RobFro96/MSP430-NRF24-WSN/3d_design/sensor_housing_nomag_220306.stl

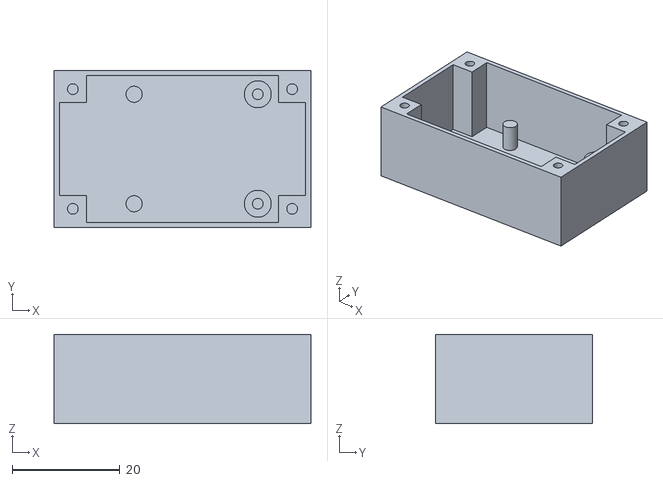
[picture p4: CAD file, 2022-03-27]
3d_design/sensor_housing_nomag_220306.stl
47.7 x 29.2 x 16.6
