RobFro96/MSP430-NRF24-WSN/3d_design/sensor_housing_220306.stl

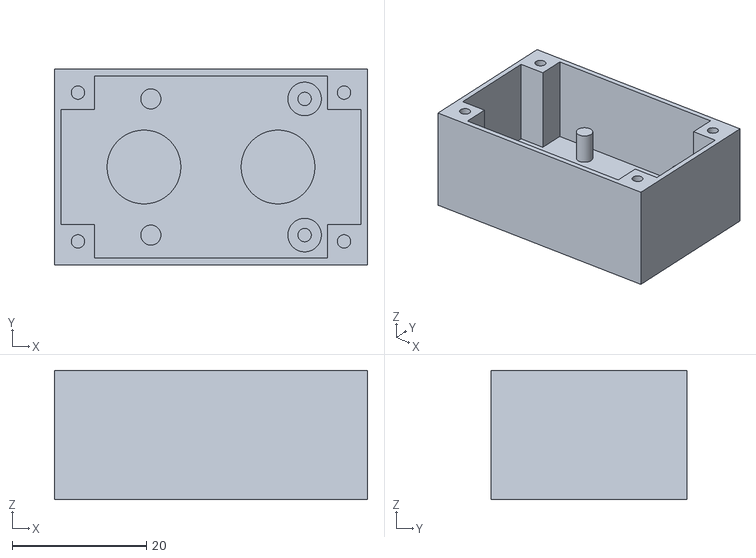
[picture p5: CAD file, 2022-03-06]
3d_design/sensor_housing_220306.stl
46.7 x 29.2 x 19.3
