RobFro96/MSP430-NRF24-WSN/3d_design/weather_station_holder_220220.stl

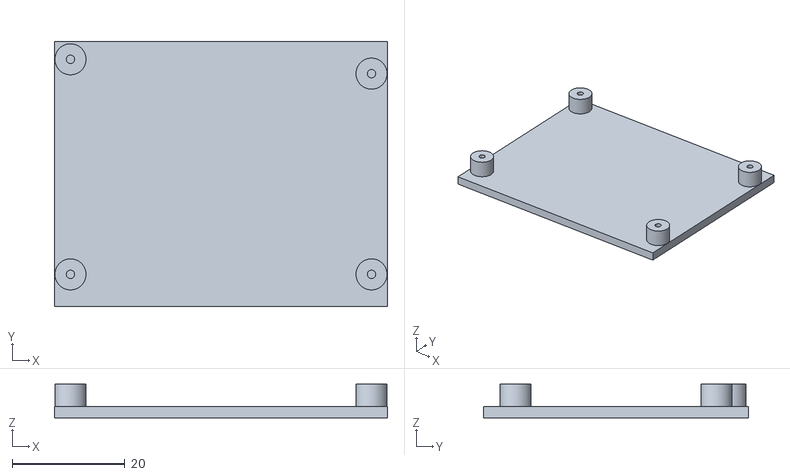
[picture p7: CAD file, 2022-02-20]
3d_design/weather_station_holder_220220.stl
59.0 x 47.0 x 6.00
