RobFro96/MSP430-NRF24-WSN/3d_design/central_housing_220218.stl

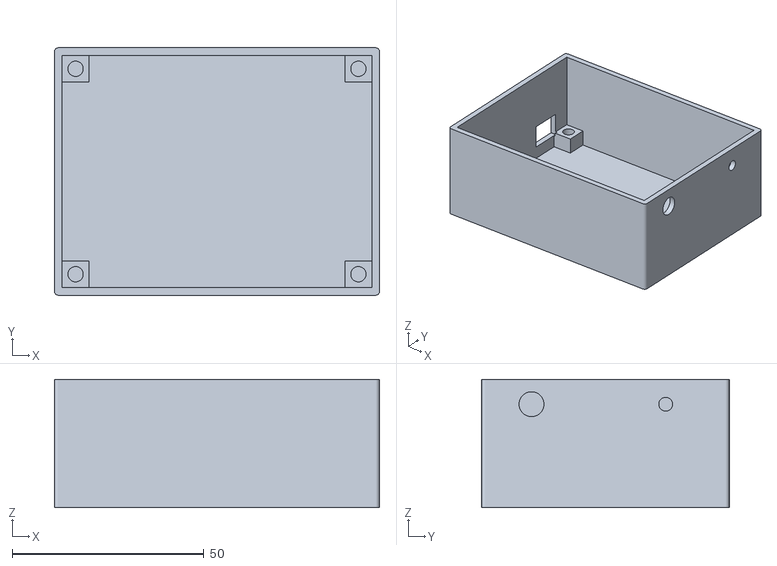
[picture p8: CAD file, 2022-02-19]
3d_design/central_housing_220218.stl
84.8 x 64.6 x 33.5
