RobFro96/MSP430-NRF24-WSN/(list of files, cad)

Other CAD files:
3d_design/sensor_housing_nomag.scad
3d_design/central_housing_220218.scad
3d_design/central_housing_lid_220218.scad
