RobFro96/MSP430-NRF24-WSN/eagle/sensor-water/sensor-water.brd

## EAGLE design eagle/sensor-water/sensor-water.brd (2025-02-25)

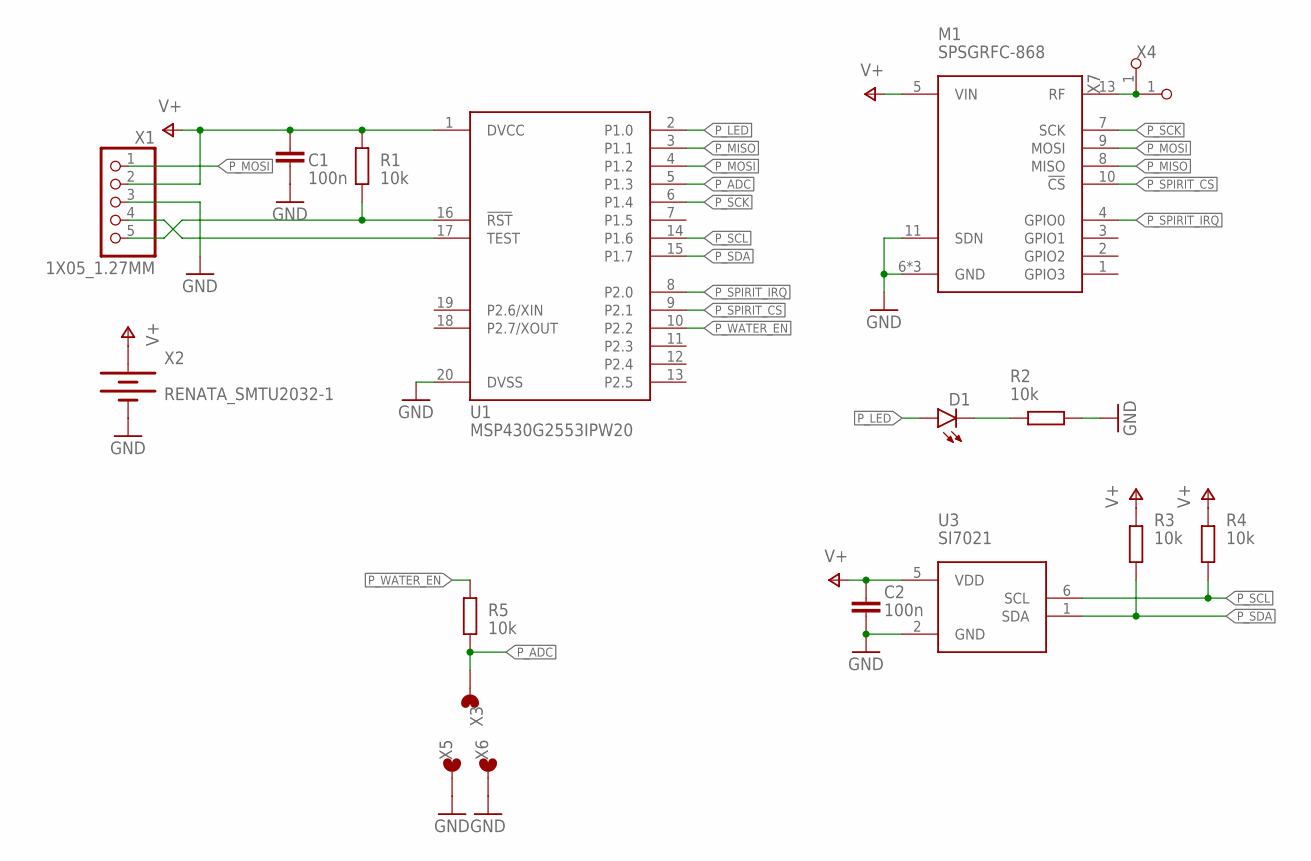
[picture p10: schematic sensor-water.sch]

Parts:
C1, C2: 100n; C0805_HAND
D1: LEDCHIPLED_0805; CHIPLED_0805
M1: SPSGRFC-868
R1, R2, R3, R4, R5: 10k; R0805_HAND
U1: MSP430G2553IPW20; PW20
U3: SI7021; DFN6-3X3
X1: 1X05_1.27MM
X2: RENATA_SMTU2032-1
X3, X5, X6: WASSERW_FOOTS
X4, X7: PINHD_1_RND; 1X01_NOSILK

Connections:
GND: C1.2, C2.2, M1.6 (GND), M1.11 (SDN), M1.12 (GND), M1.14 (GND), R2.2, U1.20 (DVSS), U3.2 (GND), X1.3, X2.2 (-), X5.1, X6.1
unnamed: D1.C, R2.1
unnamed: R1.1, U1.16 (!RST!), X1.5
unnamed: U1.17 (TEST), X1.4
unnamed: M1.13 (RF), X4.1, X7.1
P_ADC: R5.1, U1.5 (P1.3), X3.1
P_LED: D1.A, U1.2 (P1.0)
P_MISO: M1.8 (MISO), U1.3 (P1.1)
P_MOSI: M1.9 (MOSI), U1.4 (P1.2), X1.1
P_SCK: M1.7 (SCK), U1.6 (P1.4)
P_SCL: R4.1, U1.14 (P1.6), U3.6 (SCL)
P_SDA: R3.1, U1.15 (P1.7), U3.1 (SDA)
P_SPIRIT_!CS: M1.10 (!CS), U1.9 (P2.1)
P_SPIRIT_IRQ: M1.4 (GPIO0), U1.8 (P2.0)
P_WATER_EN: R5.2, U1.10 (P2.2)
V+: C1.1, C2.1, M1.5 (VIN), R1.2, R3.2, R4.2, U1.1 (DVCC), U3.5 (VDD), X1.2, X2.1 (+)

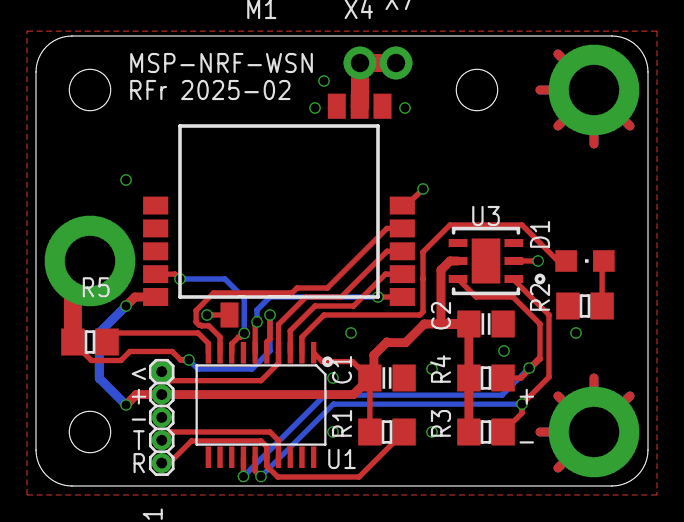
[picture p11: board sensor-water.brd from above]

Board: 2 copper layers, 34.0 x 25.0 mm, 18 parts (1 on the bottom side), 16 nets.
