RobFro96/MSP430-NRF24-WSN/eagle/sensor-multichannel/sensor-multichannel.brd

## EAGLE design eagle/sensor-multichannel/sensor-multichannel.brd (2025-02-25)

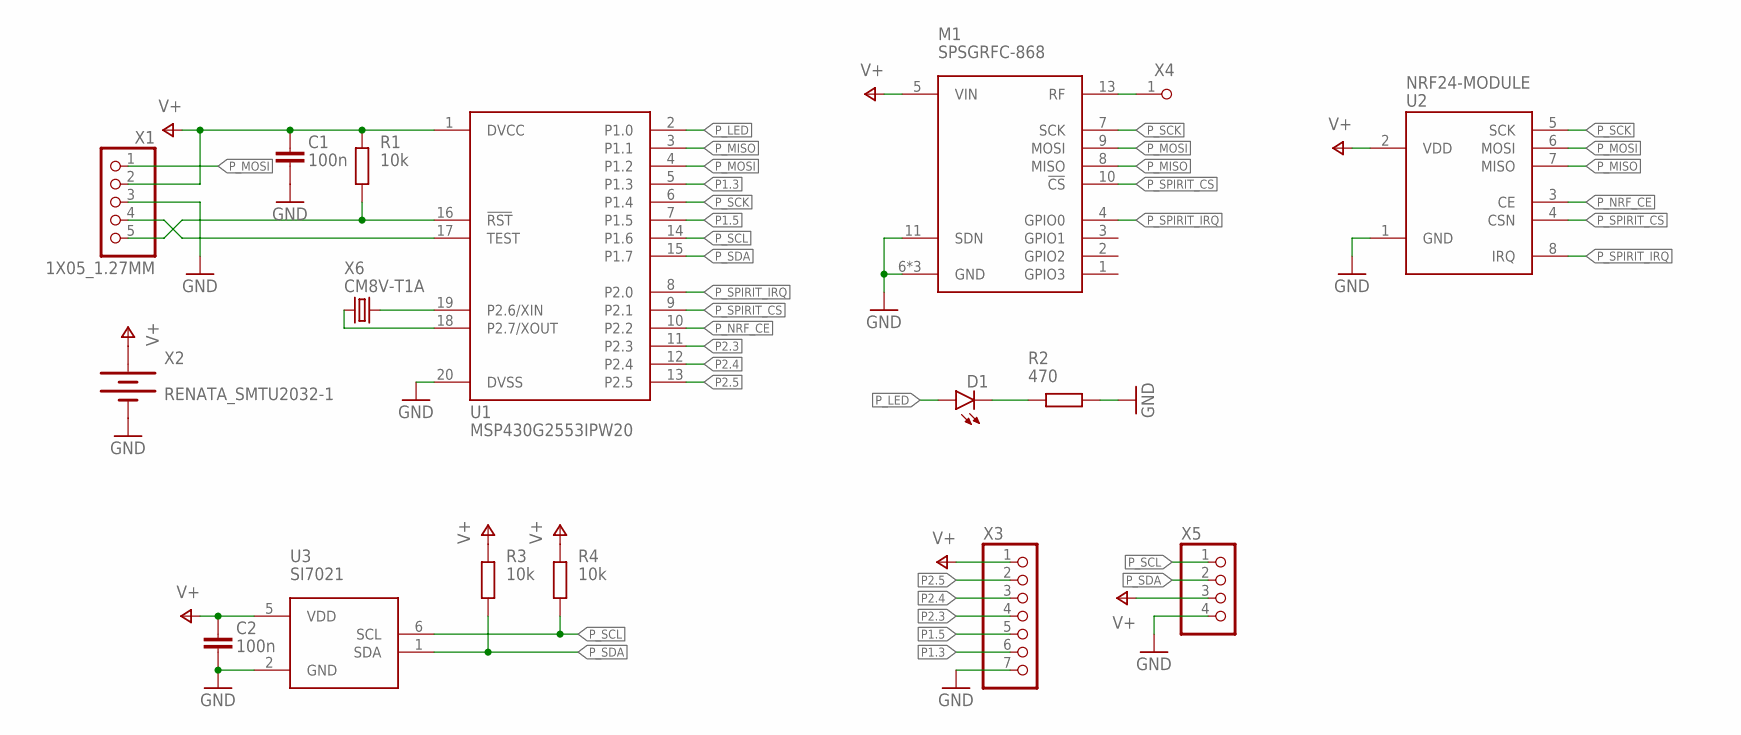
[picture p12: schematic sensor-multichannel.sch]

Parts:
C1, C2: 100n; C0603
D1: LEDCHIPLED_0805; CHIPLED_0805
M1: SPSGRFC-868
R1, R3, R4: 10k; R0603
R2: 470; R0603
U1: MSP430G2553IPW20; PW20
U2: NRF24-MODULE
U3: SI7021; DFN6-3X3
X1: 1X05_1.27MM
X2: RENATA_SMTU2032-1
X3: PINHD_7_RNDNS; 1X07_NOSILK
X4: PINHD_1_RND; 1X01_NOSILK
X5: PINHD_4_RNDNS; 1X04_NOSILK
X6: CM8V-T1A

Connections:
GND: C1.2, C2.2, M1.6 (GND), M1.11 (SDN), M1.12 (GND), M1.14 (GND), R2.2, U1.20 (DVSS), U2.1 (GND), U3.2 (GND), X1.3, X2.2 (-), X3.7, X5.4
unnamed: D1.C, R2.1
unnamed: R1.1, U1.16 (!RST!), X1.5
unnamed: U1.17 (TEST), X1.4
unnamed: M1.13 (RF), X4.1
unnamed: U1.19 (P2.6/XIN), X6.P$2 (2)
unnamed: U1.18 (P2.7/XOUT), X6.P$1 (1)
P1.3: U1.5 (P1.3), X3.6
P1.5: U1.7 (P1.5), X3.5
P2.3: U1.11 (P2.3), X3.4
P2.4: U1.12 (P2.4), X3.3
P2.5: U1.13 (P2.5), X3.2
P_LED: D1.A, U1.2 (P1.0)
P_MISO: M1.8 (MISO), U1.3 (P1.1), U2.7 (MISO)
P_MOSI: M1.9 (MOSI), U1.4 (P1.2), U2.6 (MOSI), X1.1
P_NRF_CE: U1.10 (P2.2), U2.3 (CE)
P_SCK: M1.7 (SCK), U1.6 (P1.4), U2.5 (SCK)
P_SCL: R4.1, U1.14 (P1.6), U3.6 (SCL), X5.1
P_SDA: R3.1, U1.15 (P1.7), U3.1 (SDA), X5.2
P_SPIRIT_!CS: M1.10 (!CS), U1.9 (P2.1), U2.4 (CSN)
P_SPIRIT_IRQ: M1.4 (GPIO0), U1.8 (P2.0), U2.8 (IRQ)
V+: C1.1, C2.1, M1.5 (VIN), R1.2, R3.2, R4.2, U1.1 (DVCC), U2.2 (VDD), U3.5 (VDD), X1.2, X2.1 (+), X3.1, X5.3

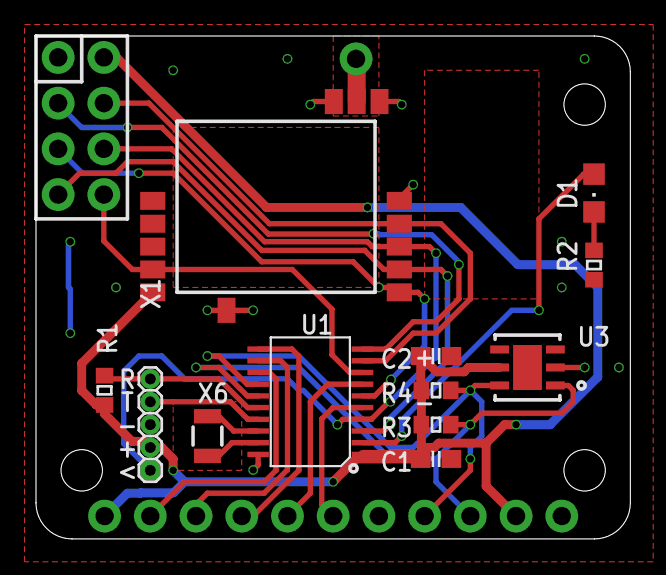
[picture p13: board sensor-multichannel.brd from above]

Board: 2 copper layers, 33.0 x 27.9 mm, 17 parts (1 on the bottom side), 22 nets.
