RobFro96/MSP430-NRF24-WSN/eagle/rpi_shield/rpi-shield.brd

## EAGLE design eagle/rpi_shield/rpi-shield.brd (2022-04-09)

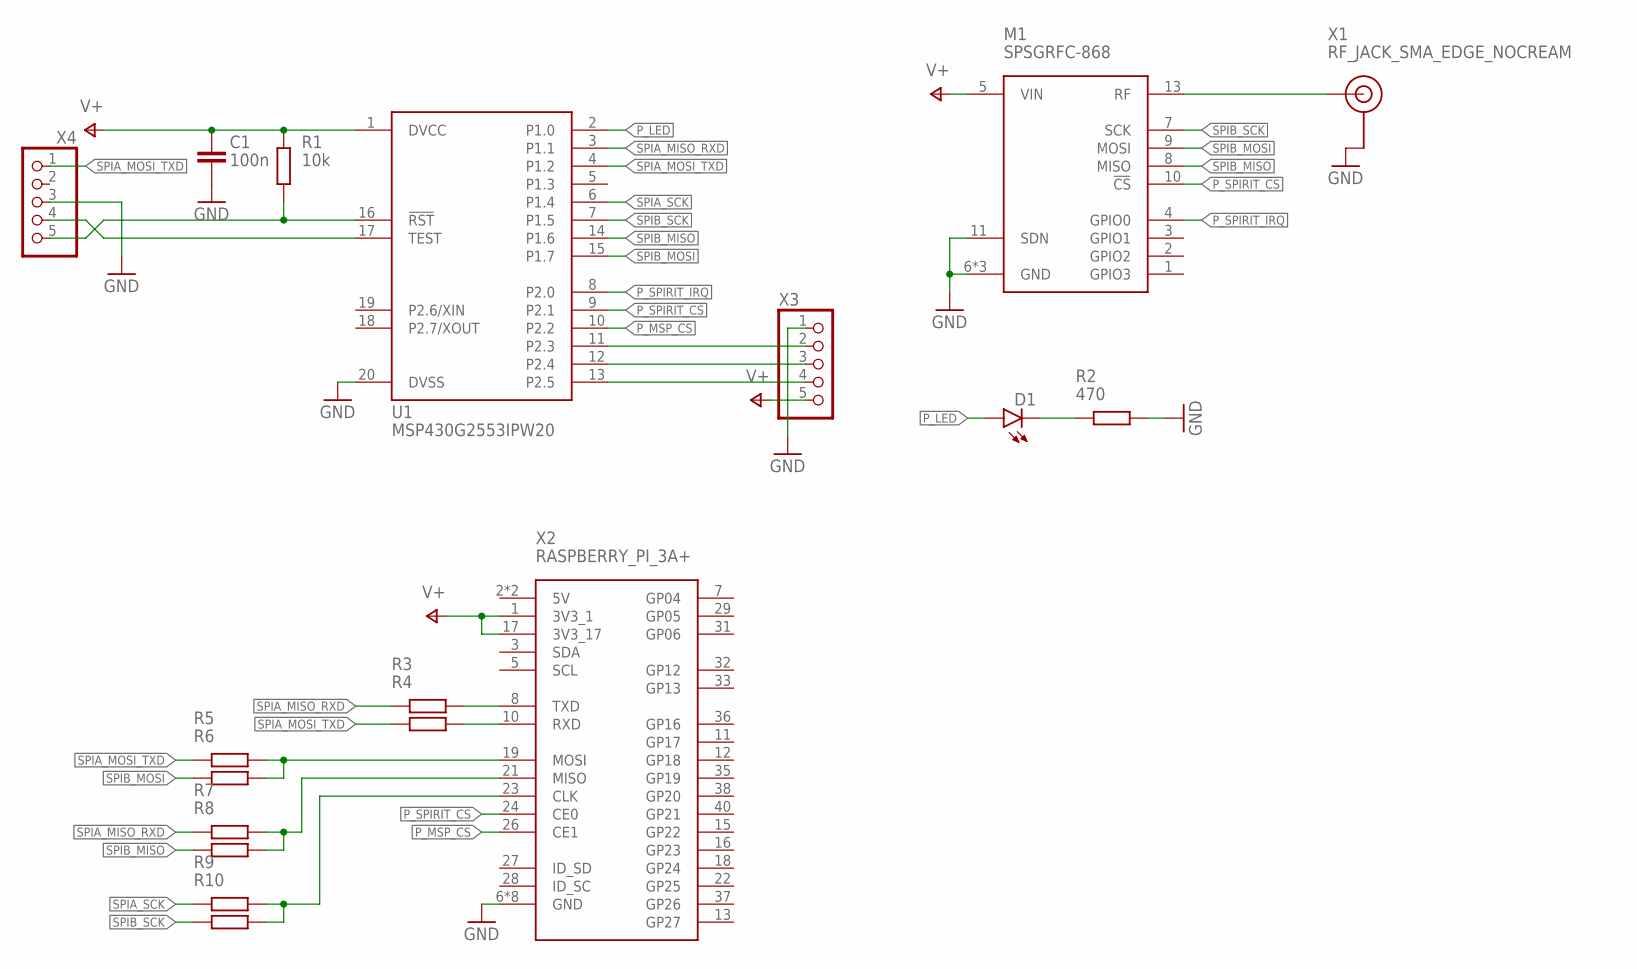
[picture p14: schematic rpi-shield.sch]

Parts:
C1: 100n; C0603
D1: LEDCHIPLED_0805; CHIPLED_0805
M1: SPSGRFC-868
R1: 10k; R0603
R2: 470; R0603
R3, R4, R5, R6, R7, R8, R9, R10: R0603_STOP
U1: MSP430G2553IPW20; PW20
X1: RF_JACK_SMA_EDGE_NOCREAM; RF_SMA_JACK_EDGE_NOCREAM
X2: RASPBERRY_PI_3A+
X3, X4: PINHD_5_RND; 1X05

Connections:
GND: C1.2, M1.6 (GND), M1.11 (SDN), M1.12 (GND), M1.14 (GND), R2.2, U1.20 (DVSS), X1.2 (GND), X1.3 (GND), X1.4 (GND), X1.5 (GND), X2.6 (GND), X2.9 (GND), X2.14 (GND), X2.20 (GND), X2.25 (GND), X2.30 (GND), X2.34 (GND), X2.39 (GND), X3.1, X4.3
unnamed: D1.C, R2.1
unnamed: R1.1, U1.16 (!RST!), X4.5
unnamed: U1.17 (TEST), X4.4
unnamed: M1.13 (RF), X1.1 (SIGNAL)
unnamed: R3.2, X2.8 (TXD)
unnamed: R4.2, X2.10 (RXD)
unnamed: R5.2, R6.2, X2.19 (MOSI)
unnamed: R7.2, R8.2, X2.21 (MISO)
unnamed: R9.2, R10.2, X2.23 (CLK)
unnamed: U1.13 (P2.5), X3.4
unnamed: U1.12 (P2.4), X3.3
unnamed: U1.11 (P2.3), X3.2
P_LED: D1.A, U1.2 (P1.0)
P_MSP_!CS: U1.10 (P2.2), X2.26 (CE1)
P_SPIRIT_!CS: M1.10 (!CS), U1.9 (P2.1), X2.24 (CE0)
P_SPIRIT_IRQ: M1.4 (GPIO0), U1.8 (P2.0)
SPIA_MISO_RXD: R3.1, R7.1, U1.3 (P1.1)
SPIA_MOSI_TXD: R4.1, R5.1, U1.4 (P1.2), X4.1
SPIA_SCK: R9.1, U1.6 (P1.4)
SPIB_MISO: M1.8 (MISO), R8.1, U1.14 (P1.6)
SPIB_MOSI: M1.9 (MOSI), R6.1, U1.15 (P1.7)
SPIB_SCK: M1.7 (SCK), R10.1, U1.7 (P1.5)
V+: C1.1, M1.5 (VIN), R1.2, U1.1 (DVCC), X2.1 (3V3_1), X2.17 (3V3_17), X3.5

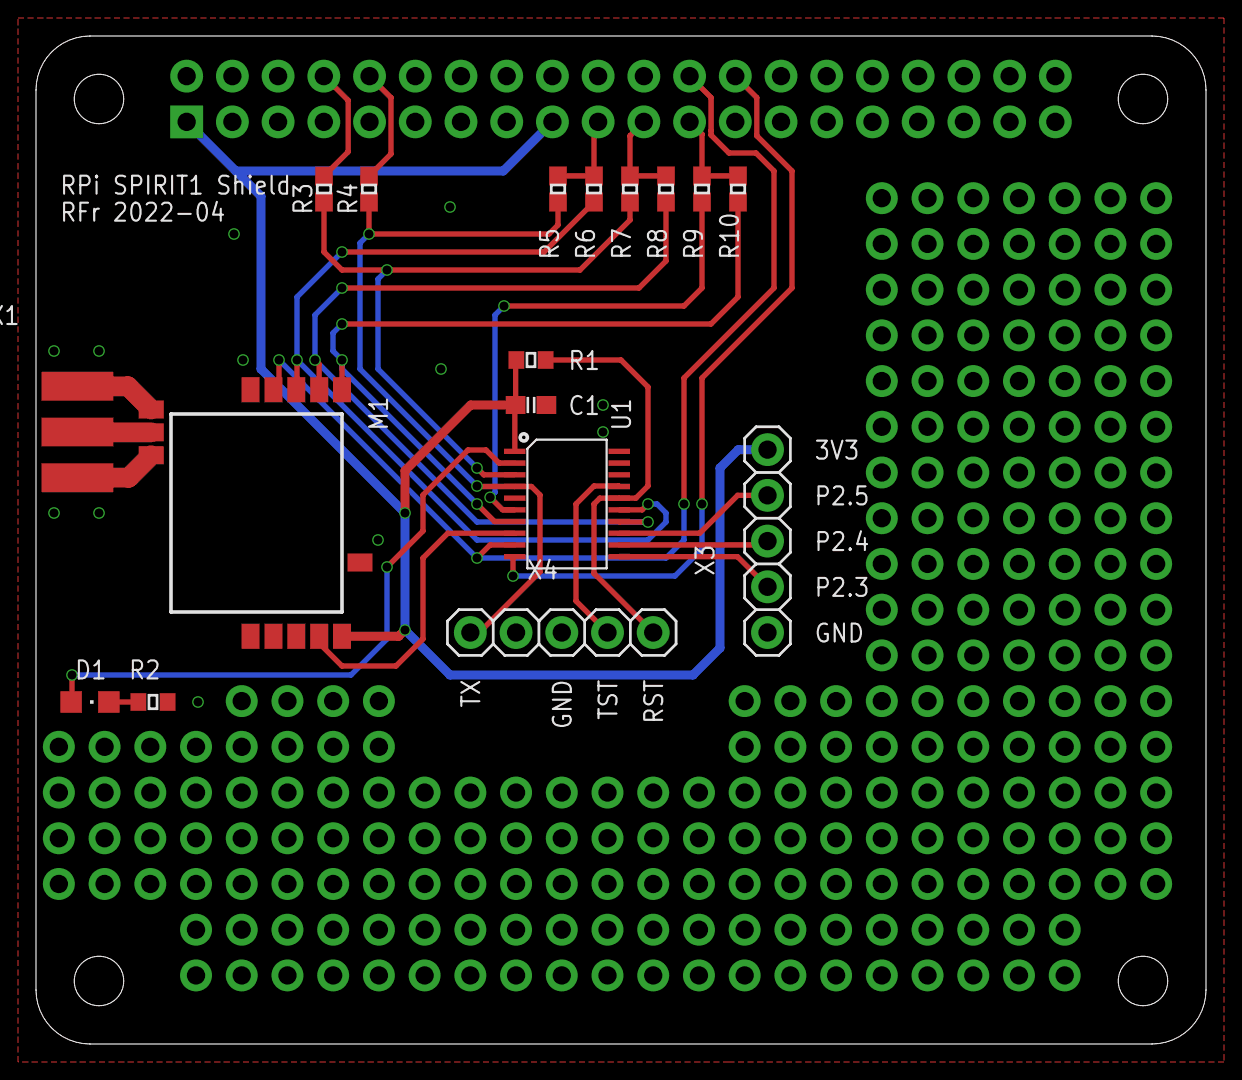
[picture p15: board rpi-shield.brd from above]

Board: 2 copper layers, 65.0 x 56.0 mm, 18 parts (0 on the bottom side), 24 nets.
