RobFro96/MSP430-NRF24-WSN/eagle/sensor-small/sensor-small.brd

## EAGLE design eagle/sensor-small/sensor-small.brd (2022-03-06)

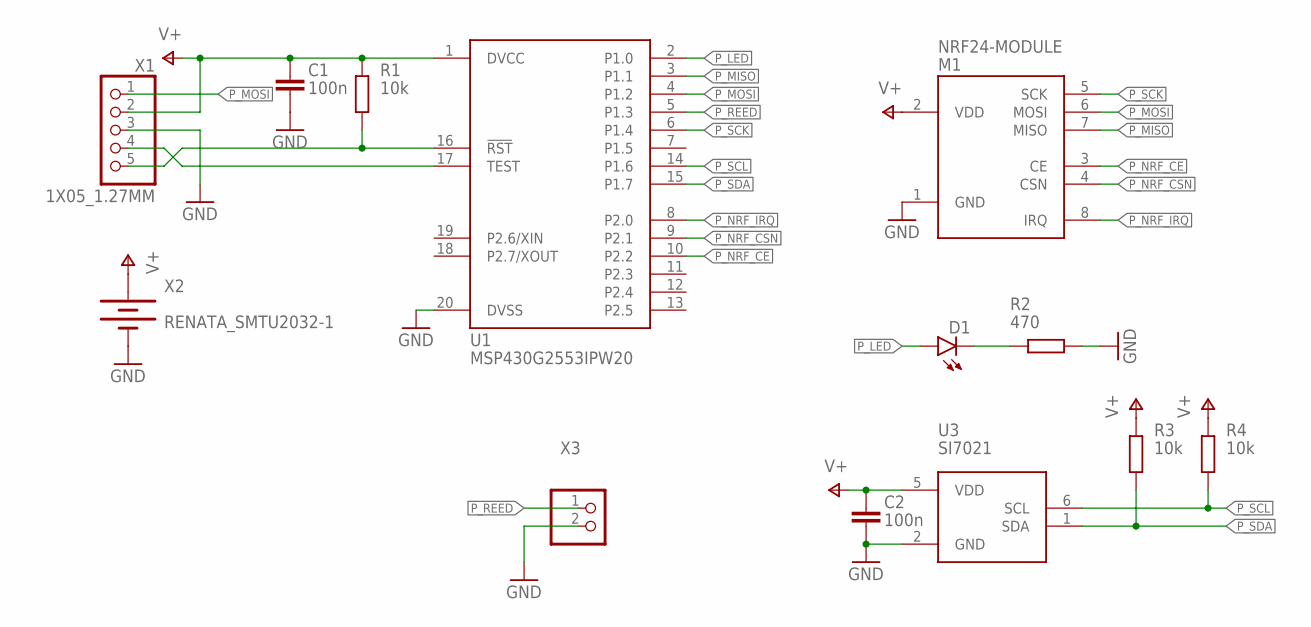
[picture p16: schematic sensor-small.sch]

Parts:
C1, C2: 100n; C0603
D1: LEDCHIPLED_0805; CHIPLED_0805
M1: NRF24-MODULE
R1, R3, R4: 10k; R0603
R2: 470; R0603
U1: MSP430G2553IPW20; PW20
U3: SI7021; DFN6-3X3
X1: 1X05_1.27MM
X2: RENATA_SMTU2032-1
X3: PINHD_2_RND; 1X02

Connections:
GND: C1.2, C2.2, M1.1 (GND), R2.2, U1.20 (DVSS), U3.2 (GND), X1.3, X2.2 (-), X3.2
unnamed: D1.C, R2.1
unnamed: R1.1, U1.16 (!RST!), X1.5
unnamed: U1.17 (TEST), X1.4
P_LED: D1.A, U1.2 (P1.0)
P_MISO: M1.7 (MISO), U1.3 (P1.1)
P_MOSI: M1.6 (MOSI), U1.4 (P1.2), X1.1
P_NRF_CE: M1.3 (CE), U1.10 (P2.2)
P_NRF_CSN: M1.4 (CSN), U1.9 (P2.1)
P_NRF_IRQ: M1.8 (IRQ), U1.8 (P2.0)
P_REED: U1.5 (P1.3), X3.1
P_SCK: M1.5 (SCK), U1.6 (P1.4)
P_SCL: R4.1, U1.14 (P1.6), U3.6 (SCL)
P_SDA: R3.1, U1.15 (P1.7), U3.1 (SDA)
V+: C1.1, C2.1, M1.2 (VDD), R1.2, R3.2, R4.2, U1.1 (DVCC), U3.5 (VDD), X1.2, X2.1 (+)

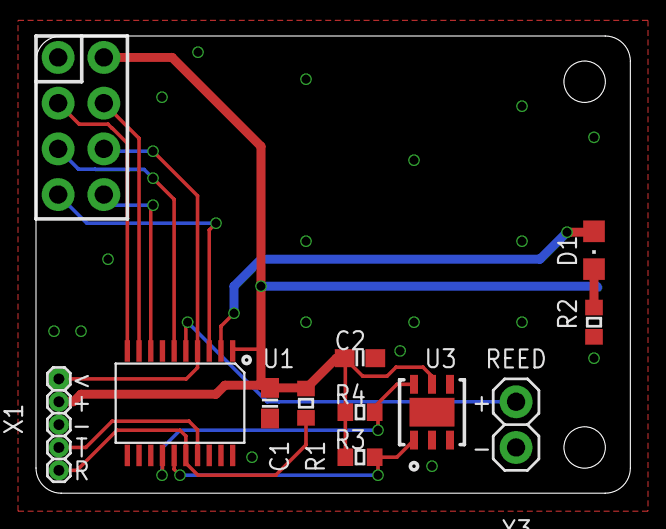
[picture p17: board sensor-small.brd from above]

Board: 2 copper layers, 33.0 x 25.4 mm, 13 parts (1 on the bottom side), 15 nets.
