RobFro96/MSP430-NRF24-WSN/firmware/msp430-spirit1-sensornode/data_collector.h

/*
 * data_collector.h
 *
 *  Created on: 12.02.2022
 *      Author: rob
 */

#ifndef DATA_COLLECTOR_H_
#define DATA_COLLECTOR_H_

void data_collector();
void data_collector_rf_values();
void data_collector_vbat();
void data_collector_temperature_internal();
void data_collector_si7021_data();
void data_collector_digital_in();
void data_collector_resistor_div();

#endif /* DATA_COLLECTOR_H_ */
