RobFro96/MSP430-NRF24-WSN/(commit log)

2022-02-11 Renamed firmware Code Composer Studio project
    [output_struct.tsv, output_struct.xlsx]
2022-02-11 Added internal temperature measurement and Si7021 support
2022-02-12 Added support form BMP180 temperature and pressure sensor
    [output_struct.tsv, output_struct.xlsx]
2022-02-12 Added support for a reed switch
    [output_struct.tsv, output_struct.xlsx]
2022-02-13 Added eagle/ directory, central design on Perfboard
    [central-perfboard.brd, central-perfboard.sch]
2022-02-13 Added sensor to central communication and retry logic
2022-02-14 Added in_regs and acknowledgement
    [input_struct.tsv, input_struct.xlsx]
2022-02-15 started central housing 3D design
    [central_housing.scad, central_housing.stl]
2022-02-17 out_regs.retries not to reset until successful transmission
    [data_collector.c, sensor.c]
2022-02-17 Added Eagle schematic and layout for small sensor board
    [sensor-small.brd, sensor-small.sch]
2022-02-18 Fixed swapped RST and TEST line in EAGLE design
    [sensor-small.brd, sensor-small.sch]
2022-02-19 Finished 3D design of central housing (performing test print)
    [central_housing.scad, central_housing.stl, central_housing_220218.scad, central_housing_220218.stl, central_housing_lid_220218.scad, central_housing_lid_220218.stl]
2022-02-19 Finished sensor programming, added measurements for battery life time estimations
    [input_struct.tsv, input_struct.xlsx]
2022-02-20 Added Eagle design for weather station on perfboard, changed config.h accordingly
    [sensor-weather-perfboard.brd, sensor-weather-perfboard.sch]
2022-02-20 Added 3D design for weather station PCB holder
    [weather_station_holder.scad, weather_station_holder_220220.stl]
2022-02-20 Finished Central firmware to send out_regs and receiver in_regs over UART
2022-02-24 Added server, write incoming data to database
    [output_struct.tsv, output_struct.xlsx]
2022-02-26 Added conditional LED output
2022-03-06 Changed LED resistor value
    [sensor-small.brd, sensor-small.sch]
2022-03-06 Added sensor housing 3D design
    [sensor_housing.scad, sensor_housing_220306.scad, sensor_housing_220306.stl, sensor_housing_lid_220306.stl]
2022-03-27 Added sensor housing design, without magnetic holder
    [sensor_housing_nomag.scad, sensor_housing_nomag_220306.stl]
2022-04-09 Added EAGLE design for Sensor and Raspberry Pi Shield for SPIRIT1 868 MHz transceiver
    [rpi-shield.brd, rpi-shield.sch, sensor-small.brd, sensor-small.sch]
2022-05-22 Added old sensornode functionality to SPIRIT1 project
2022-07-16 Added receiver RSSI value to out_regs and database
    [output_struct.tsv, output_struct.xlsx]
2025-01-05 Big change: Simplified firmware to use lists instead of registers, adapted central firmware, too
    [input_struct.tsv, input_struct.xlsx, output_struct.tsv, output_struct.xlsx]
2025-01-08 Added Sensor with S0 interface for energy meter
2025-02-25 Added EAGLE designs
    [sensor-multichannel.brd, sensor-multichannel.sch, sensor-water.brd, sensor-water.sch]
